foamflare/jy901_checkFirst/关于数据手套第一阶段的总结/手套图.jpg

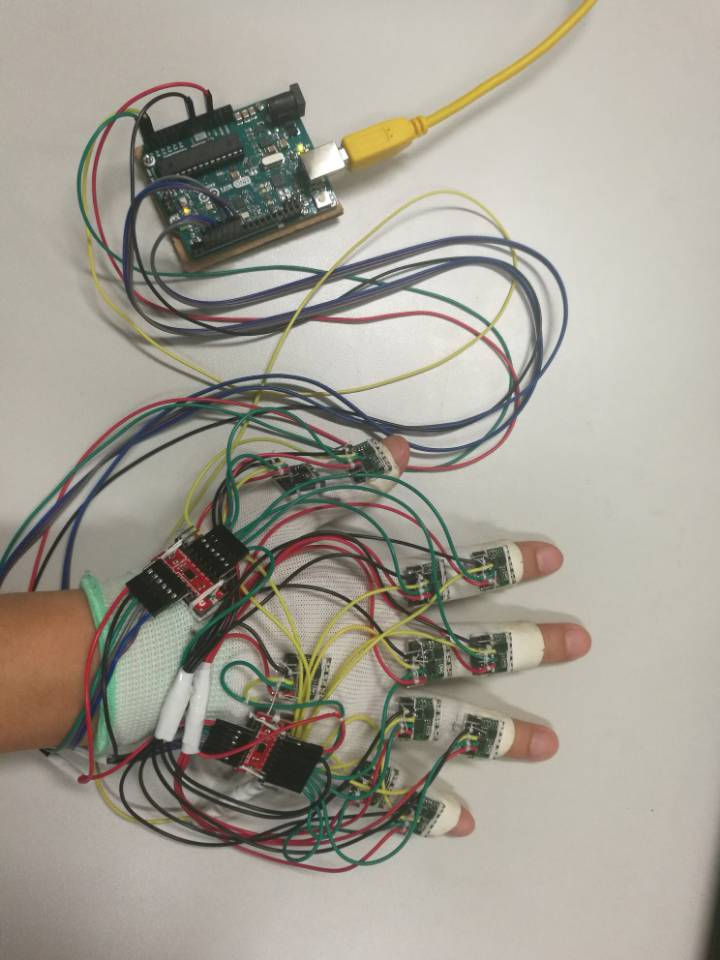
关于数据手套第一阶段的总结/手套图.jpg
