foamflare/jy901_checkFirst/README.md

# jy901_checkFirst
使用JY901采集到传感器roll yaw pitch角，然后加上手掌约束模型，使用blender仿真工具进行手指实时跟踪

其中 2018-3-21 里面是arduino程序和blender程序。
