foamflare/jy901_checkFirst/关于数据手套第一阶段的总结/文件说明.txt

finger1.m 是读取一个文件，其中包括陀螺仪传感器数据，控制一个圆环转动。
getPic.m 只是一个画图的函数
inertial_pdr.m  传统的使用Zupt进行室内定位的代码

jy901.ino 使用I2C串口传输协议，读取jy901惯性传感器数据
mpu9250_getMessage.ino  使用I2C串口传输协议，读取mpu9250传感器数据
ReadComData.m  读取串口数据，使用陀螺仪传感器数据控制一个立方体的运动，检测jy901的得到的角度稳定性
