foamflare/jy901_checkFirst/(list of files, cad)

Other CAD files:
关于数据手套第一阶段的总结/2018-03-21/RightHandV2.blend
